VanTu1208/AmazingIoT_Intern_T9/PCB/PCB_Linh_Kien_Cam/Gateway_V2_Final_Submit/Gateway_Final.xlsx

Comment | Description | Designator | Footprint | LibRef | Quantity
Buzzer 12095 | MAGNETIC BUZZER AND TRANSDUCER - More Details | BUZ | FP-MCKPX-G1203A-K4056-MFG | CMP-12433-000001-1 | 1
100uF | Cắm | C1, C2 | tu hoa 5mm | Tu Hoa 100uF 16V 5x7 | 2
1000uF | Cắm | C3, C4 | tu hoa 8mm | Tu Hoa 1000uF 16V 8x20 | 2
0.1uF | Cắm | C5, C7, C9 | tu hoa 5mm | Tu Hoa 0.1uF 50V 5x11 | 3
10uF | Cắm | C6, C11 | tu hoa 4mm | Tu Hoa 10uF 25V 4x7 | 2
22uF | Cắm | C8 | tu hoa 5mm | Tu Hoa 22uF 35V 5x11 | 1
4.7uF | Cắm | C10 | tu hoa 5mm | Tu Hoa 4.7uF 50V 5x11 | 1
20pF | Căm | C12, C13, C14, C15, C20, C21 | tu gom | Tu gom 20pF 50V | 6
100nF | Cắm | C16, C17, C18, C19 | tu tantalum dip5.08 | Tu tantalum 100nF 50V 20% DIP5.08 | 4
22pF | Cắm | C22 | tu gom | Tu gom 22pF 50V | 1
100uF | Cắm | C23 | Tu hoa 10mm | Tu Hoa 100uF 100V 10x20 | 1
220uF | Cắm | C24 | tu hoa 10mm | Tu Hoa 220uF 50V 10x14 | 1
SS34 | Schottky Diode | D1, D2, D3 | SS14 | D Schottky | 3
SS34 | Dán | D4 | DIODE SMA | Diode SS34 ( 1N5822 ) | 1
SWD | Cắm | H1 | Header 4P DC 2.54 | Header 4P 2.54 Duc Cong | 1
Jac DC 12V | Jac DC input | JDC1 | DC-IN | DCIN | 1
JP 1x6 2.54 | Cắm | JP1, JP2 | JP 1x6 CT | JP 1x6 2.54 Cai Thang | 2
JP 2x3 2.54 | Cắm | JP3 | JP 2x3 DT | JP 2x3 2.54 Duc Thang | 1
JP 1x10 2.54 | Cắm | JP4, JP5 | JP 1x10 DT | JP 1x10 2.54 Duc Thang | 2
JP 2x4 2.54 | Cắm | JP6, LORA | JP 2x4 CT | JP 2x4 2.54 Cai Thang | 2
100uH - 3A SMD | Dán | L1, L2 | Cuon Cam 12x12x10 | CUON CAM 100uH SMD | 2
33uH - 3A SMD | Dán | L3 | Cuon Cam 12x12x10 | CUON CAM 100uH SMD | 1
LED 3mm | Cắm | LED1, LED2 | LED-3MM-GREEN | LED 3mm Xanh La | 2
LED 5mm | Cắm | LED3 | LED-5MM 2 MAU | LED 5mm 2 mau Anot chung | 1
2N3904 | General Purpose Transistor, NPN Silicon, 200 mA, 60 V, -55 to 150 degC, 3-Pin TO-92, RoHS, Bulk | Q1, Q2, Q3, Q4, Q5 | ONSC-TO-92-3-29-11 | CMP-2000-05562-1 | 5
10k | Căm, Cắm | R1, R2, R5, R7, R12 | tro vach 1/4w | Tro Vach 1/4W 5% 10k, Tro Vach 1/4W 1% 10k | 5
1k | Cắm | R3, R4, R14, R19 | tro vach 1/4w | Tro Vach 1/4W 5% 1k | 4
0R | Cắm | R6 | tro vach 1/4w | Tro Vach 1/4W 1% 10k | 1
100k | Cắm | R8, R9 | tro vach 1/4w | Tro Vach 1/4W 5% 100k | 2
1M | Cắm | R10, R11 | tro vach 1/4w | Tro Vach 1/4W 5% 1M | 2
220R | Cắm | R13, R15, R16, R17 | tro vach 1/4w | Tro Vach 1/4W 5% 220R, Tro Vach 1/4W 5% 1k | 4
4.7k | Cắm | R18 | tro vach 1/4w | Tro Vach 1/4W 5% 4.7k | 1
2.2k | Cắm | R20 | tro vach 1/4w | Tro Vach 1/4W 5% 2.2k | 1
RST | SWITCH TACTILE SPST-NO 0.05A 12V | SW1 | Button 3x4mm | SW2 | 1
FLASH | SWITCH TACTILE SPST-NO 0.05A 12V | SW2, SW3 | Button 3x4mm | SW2 | 2
ESP-WROOM-32 | ESP-WROOM-32 (8MB), WIFI MODULE 64 MBITS SPI FLASH | U1 | ESP32 WROOM | ESP-WROOM-32 | 1
STM32F103C8T6 | ARM Cortex-M3 32-bit MCU, 64 KB Flash, 20 KB Internal RAM, 37 I/Os, 48-pin LQFP, -40 to 85 degC, Tray | U2 | STM-LQFP48_L | CMP-0237-00215-3 | 1
LM2576S-5.0 | SIMPLE SWITCHER® 3A Step-Down Voltage Regulator, 5-pin TO-263 | U3 | KTT0005B_N | CMP-0069-00115-3 | 1
LM2576S-3.3 | SIMPLE SWITCHER® 3A Step-Down Voltage Regulator, 5-pin TO-263 | U4 | TS5B_M | CMP-0069-00113-2 | 1
RT9193-33GB | Linear Voltage Regulator IC 1 Output 300mA SOT-23-5 | U5 | SOT23-5 | REG_5.5V-3.3V-0.3A-1W-SOT-23-5 | 1
CP2102-QFN28 | USB Bridge, USB to UART USB 2.0 UART Interface 28-QFN (5x5) | U6 | CP2102-QFN28 | CP2102 | 1
LM2596S-12 | SIMPLE SWITCHER® Power Converter 150 KHz 3A Step-Down Voltage Regulator, 5-pin TO-263 | U7 | TS5B_M | CMP-0069-00274-2 | 1
USB_Micro | USB - micro B USB 2.0 Receptacle Connector 5 Position Surface Mount, Right Angle; Through Hole | USB1 | USB_MICRO_B - Digikey | USB_MINI | 1
XH4 |  | XH1 | XH4/2.54mm/90 | XH4 | 1
ABLS2-8.000MHZ-D4Y-T | CRYSTAL 8.0000MHZ 18PF SMD | Y1 | FP-ABLS2-MFG | CMP-27762-001729-1 | 1
ABS25-32.768KHZ-T | CRYSTAL 32.7680KHZ 12.5PF SMD | Y2 | FP-ABS25-MFG | CMP-2000-05037-2 | 1
