VanTu1208/AmazingIoT_Intern_T9/Hop3D/Nắp hộp Node.stl

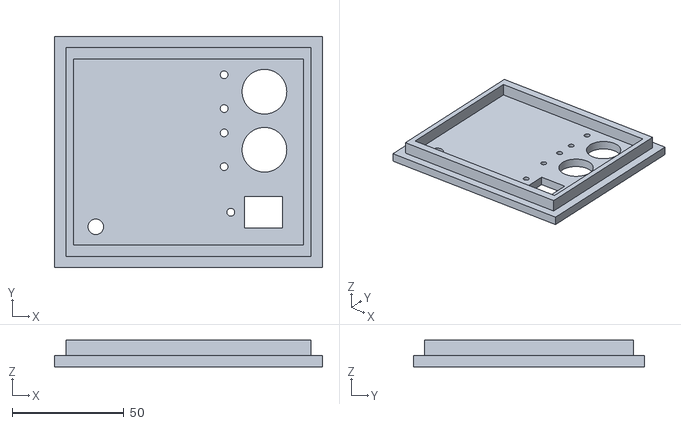
[picture p1: CAD file, 2024-12-09]
Hop3D/Nắp hộp Node.stl
120.0 x 103.5 x 12.0
