VanTu1208/AmazingIoT_Intern_T9/Hop3D/Nắp hộp GW.stl

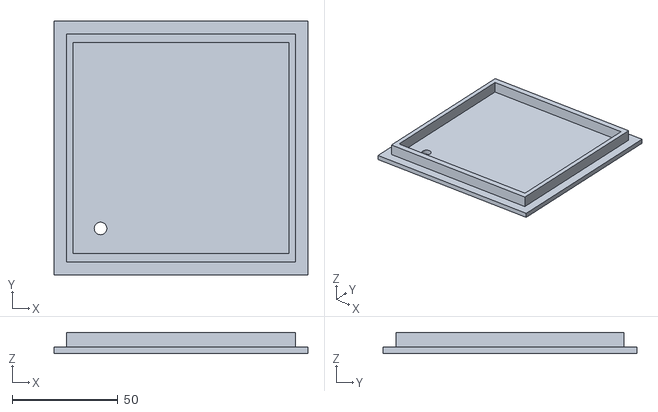
[picture p2: CAD file, 2024-12-09]
Hop3D/Nắp hộp GW.stl
120.0 x 120.0 x 10.0
