VanTu1208/AmazingIoT_Intern_T9/Hop3D/Đáy hộp Node.stl

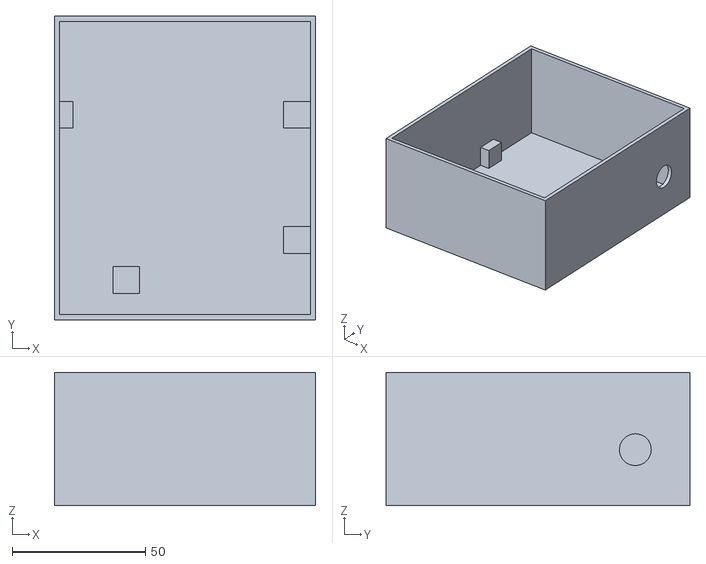
[picture p3: CAD file, 2024-12-09]
Hop3D/Đáy hộp Node.stl
98.0 x 114.0 x 50.0
