VanTu1208/AmazingIoT_Intern_T9/Hop3D/Đáy hộp GW.stl

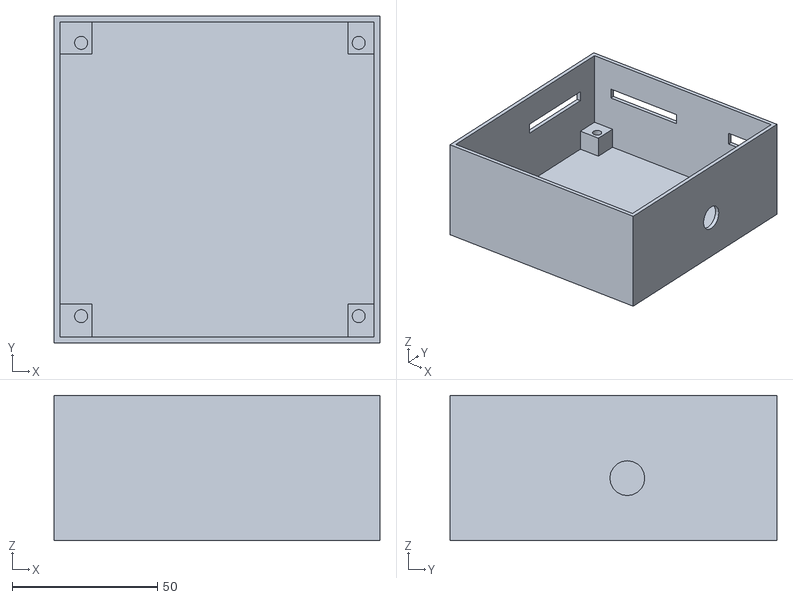
[picture p4: CAD file, 2024-12-09]
Hop3D/Đáy hộp GW.stl
112.0 x 112.5 x 50.0
