VanTu1208/AmazingIoT_Intern_T9/PCB/PCB_Linh_Kien_Cam/Gateway_V2_Final_Submit/Gateway.pdf

# 5V-3V3 POWER

# 1000uF +C?

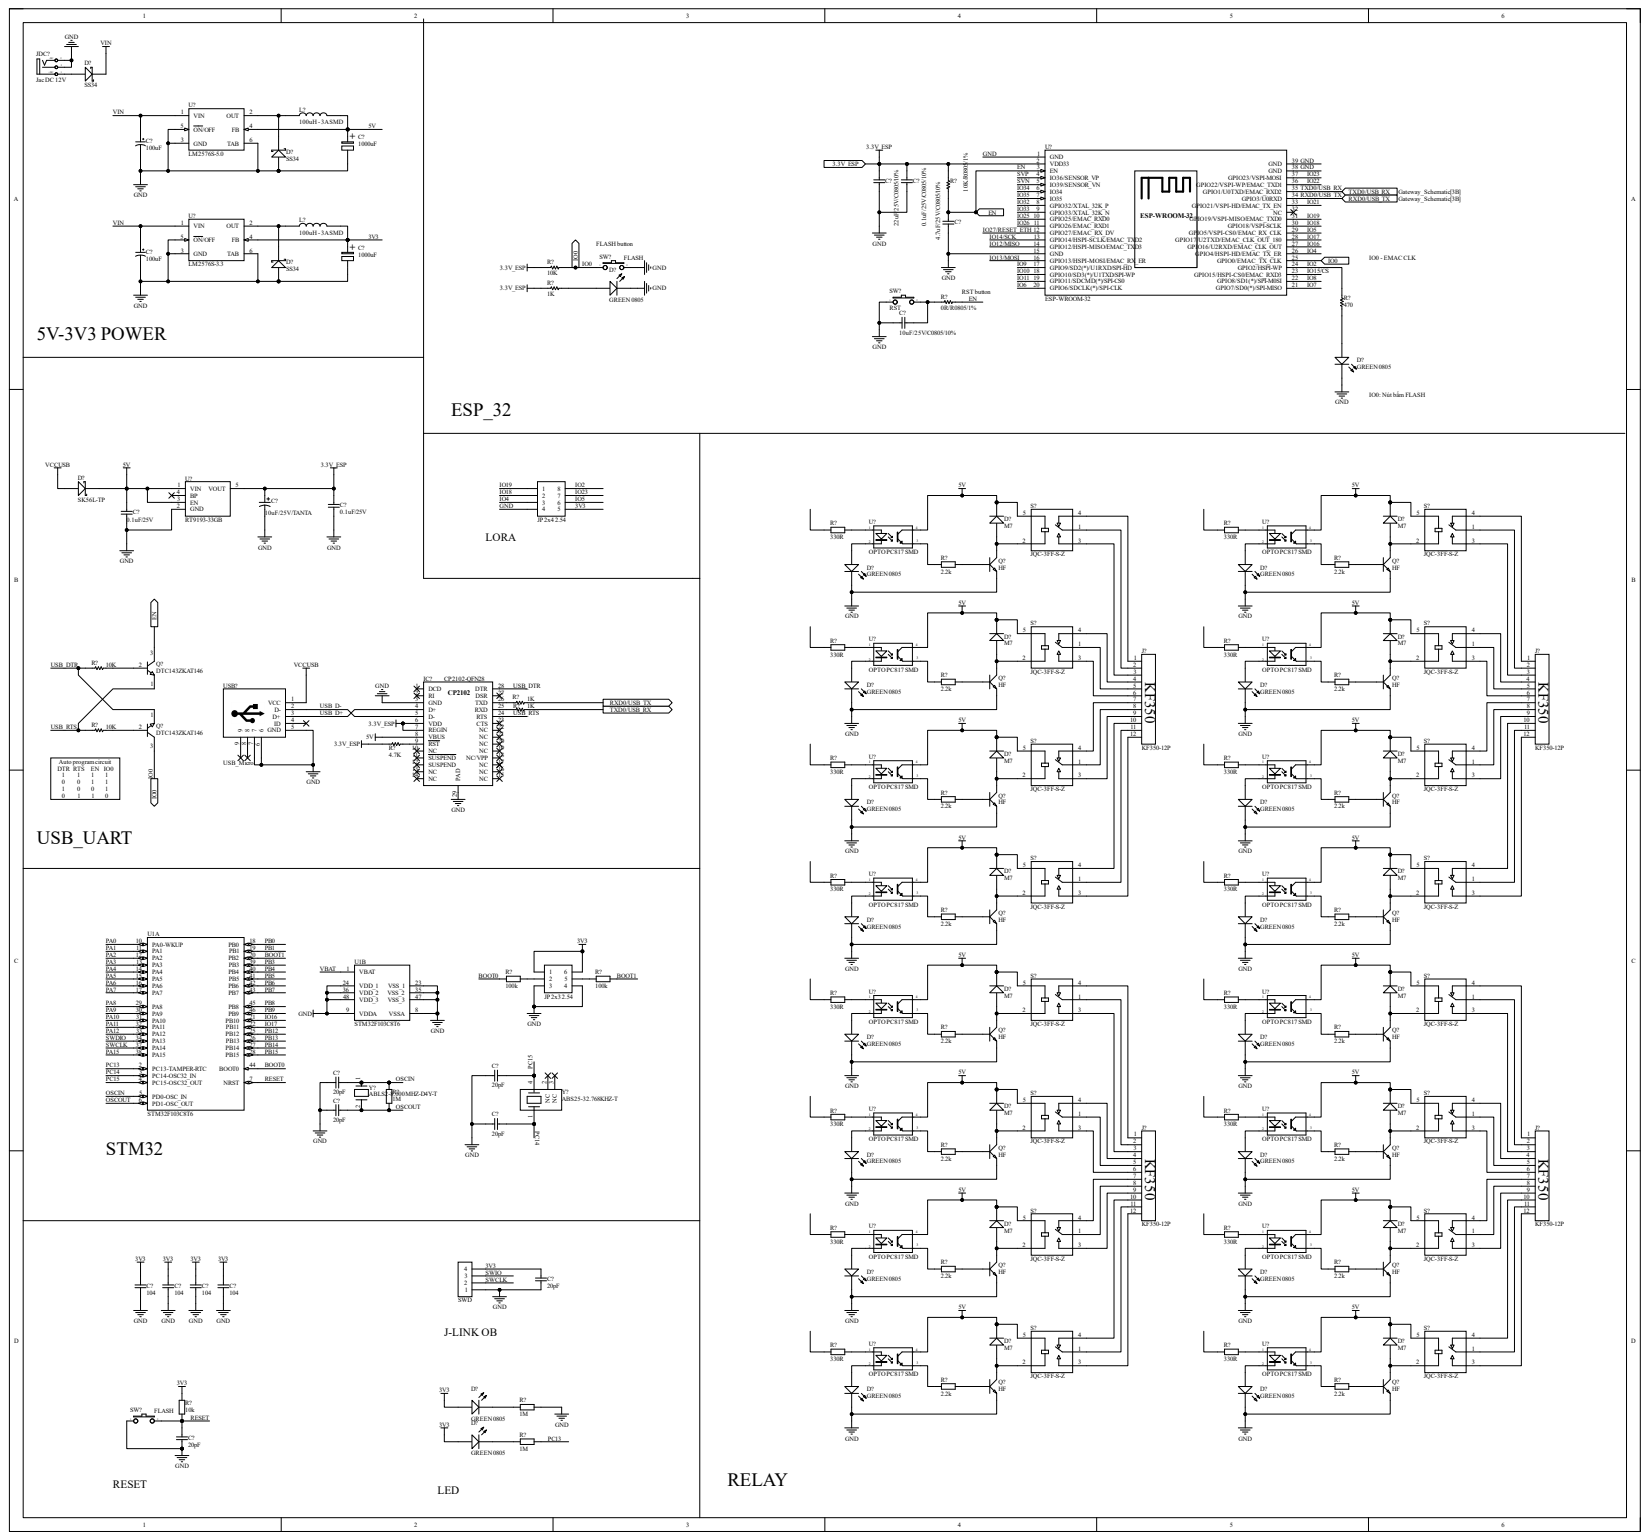
[picture p5: page 1]
3.3V_ESP; R? 10K/R⁰⁸⁰⁵/1% C? 22uF/25V/C⁰⁸⁰⁵/10%; C? 0.1uF/25V/C⁰⁸⁰⁵/10%; C? 4.7uF/25V/C⁰⁸⁰⁵/10% GND; RST C?; GND; GND 1 VDD33 2 EN 3 IO36/SENSOR_VP 4 IO39/SENSOR_VN 5 IO34 6 IO35 7 GPIO32/XTAL_32K_P 8 GPIO33/XTAL_32K_N 9 GPIO25/EMAC_RXD0 10 GPIO26/EMAC_RXD1 11 GPIO27/EMAC_RX_DV 12 GPIO14/HSPI-SCLK/EMAC_TXD2 13 GPIO12/HSPI-MISO/EMAC_TXD3 14 GND 15 GPIO13/HSPI-MOSI/EMAC_RX_ER 16 GPIO9/SD2(*)/U1RXD/SPI-HD 17 GPIO10/SD3(*)/U1TXD/SPI-WP 18 GPIO11/SDCMD(*)/SPI-CS0 19; GPIO23/VSPI-MOSI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

IO0: Nút bấm FLASH

Auto program circuit
DTR RTS EN IO0
USB_UART
