VanTu1208/AmazingIoT_Intern_T9/PCB/PCB_Linh_Kien_Cam/Gateway_V2_Final_Submit/Gateway_2.pdf

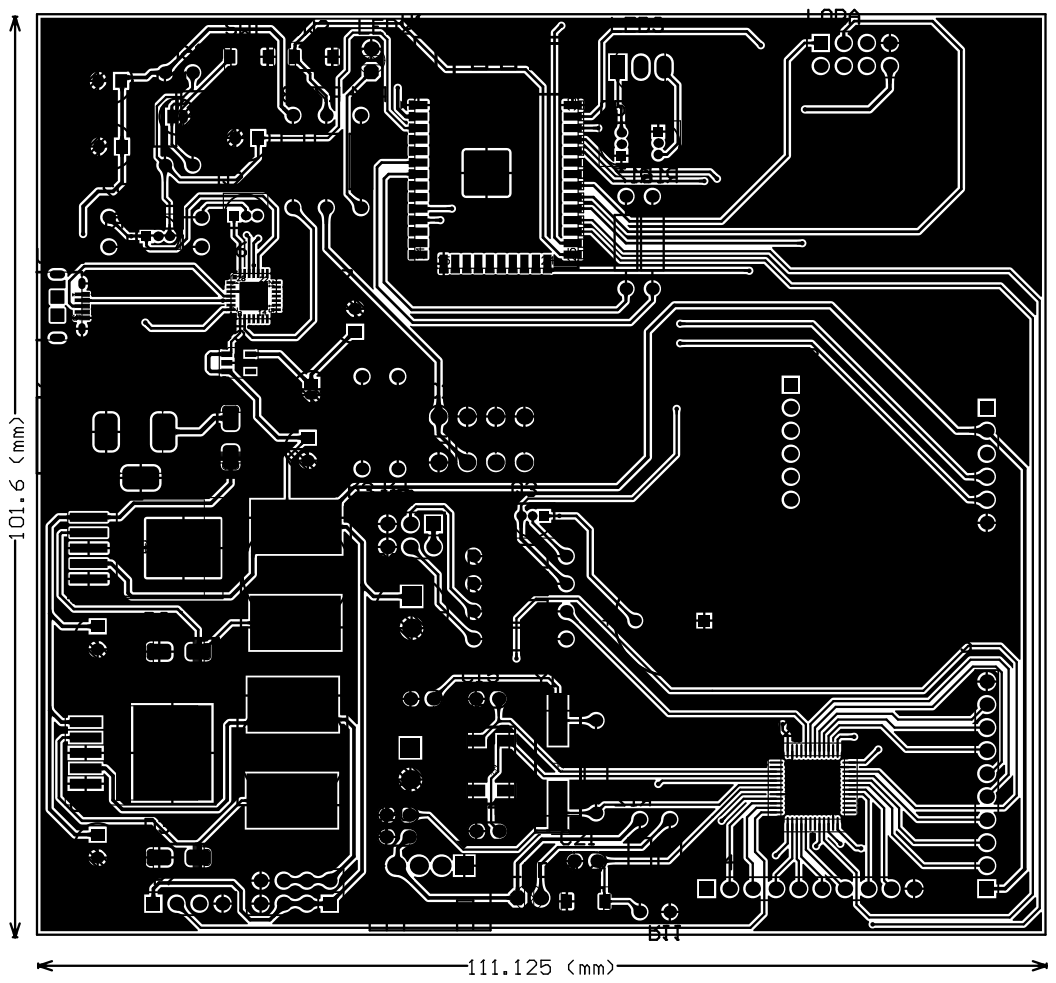
[picture p6: page 1]
