VanTu1208/AmazingIoT_Intern_T9/PCB/PCB_Linh_Kien_Cam/Node/top_pcb_mirror.pdf

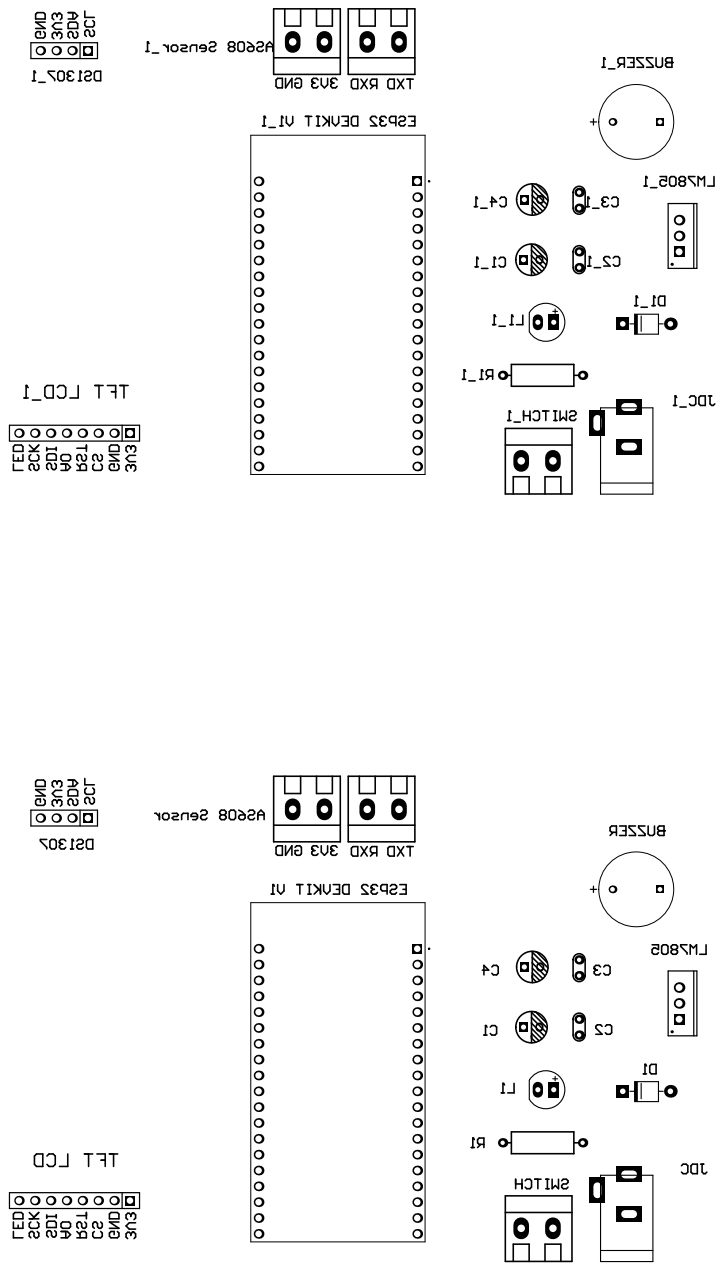
[picture p7: page 1]
