VanTu1208/AmazingIoT_Intern_T9/(list of files, drawings)

Other design files:
PCB/PCB_Linh_Kien_Cam/Gateway_V2_Final_Submit/Gateway_Final.PrjPcb
PCB/PCB_Linh_Kien_Cam/Gateway_V2_Final_Submit/Gateway_V2.0_Final_Schematic.SchDoc
PCB/PCB_Linh_Kien_Cam/Node/Node.PrjPcb
PCB/PCB_Linh_Kien_Cam/Node/Node_PCB.PcbDoc
PCB/PCB_Linh_Kien_Cam/Node/Node_Schematic.SchDoc
PCB/PCB_Linh_Kien_Dan/CONTROLER_NTH/CONTROLER.PcbDoc
PCB/PCB_Linh_Kien_Dan/CONTROLER_NTH/CONTROLER.SchDoc
PCB/PCB_Linh_Kien_Dan/CONTROLER_NTH/controler_HAUDEPZAI.PrjPcb
PCB/PCB_Linh_Kien_Dan/Gateway_V2_Final/Gateway_Final.PrjPcb
PCB/PCB_Linh_Kien_Dan/Gateway_V2_Final/Gateway_V2.0_Final_Schematic.SchDoc
PCB/PCB_Linh_Kien_Dan/NodeSensor_V2/Node_PCB_V2.PcbDoc
PCB/PCB_Linh_Kien_Dan/NodeSensor_V2/Node_Schematic_V2.SchDoc
PCB/PCB_Linh_Kien_Dan/NodeSensor_V2/NodeSensor_V2.PrjPcb
