VanTu1208/AmazingIoT_Intern_T9/Code/Esp32Gateway/include/Wifi_Config.h

#ifndef WIFICONFIG_H
#define WIFICONFIG_H

#include <WiFiManager.h>
#include "buzzer.h"
#include "saveEeprom.h"
extern int shouldResetWiFi;
extern WiFiManager wifiManager;
extern String resetState;

void setup_wifi();
void WiFi_Reset();
void reconnectWiFi(void *);
#endif // LIBRARY_H
