VanTu1208/AmazingIoT_Intern_T9/Code/Esp32Gateway/include/saveEeprom.h

#ifndef SAVEEEPROM_H
#define SAVEEEPROM_H

#include <Arduino.h>
#include <Preferences.h> 


void saveToEEPROM(const String& url);
String readFromEEPROM();
void clearEEPROM();  // Khai báo hàm xóa

#endif
